emileland/CommandErgo/README.md

# CommandErgo
 Interface manette/clavier pour personne en situation de handicap
