emileland/CommandErgo/teensy/schema png.png

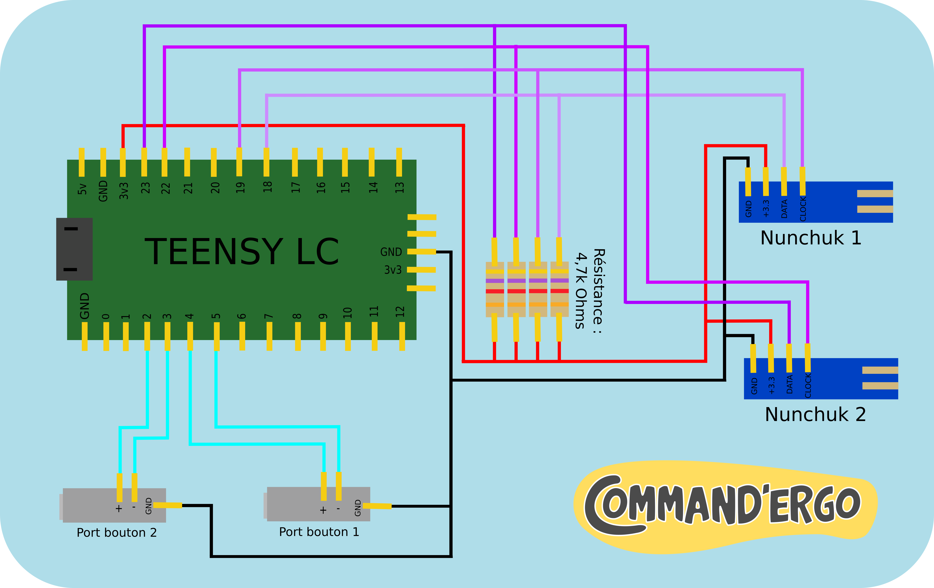
teensy/schema png.png
