emileland/CommandErgo/3D/FreeCAD/Bouton secondaire gauche droite.FCStd

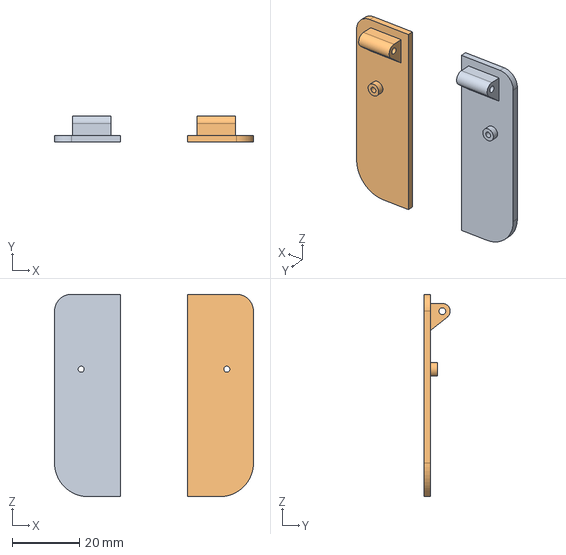
[picture p12: CAD file, 2022-06-10]
3D/FreeCAD/Bouton secondaire gauche droite.FCStd
59.0 x 7.80 x 60.0 mm
Pocket (Mirror #1)
