emileland/CommandErgo/3D/STL/boitier secondaire gauche.stl

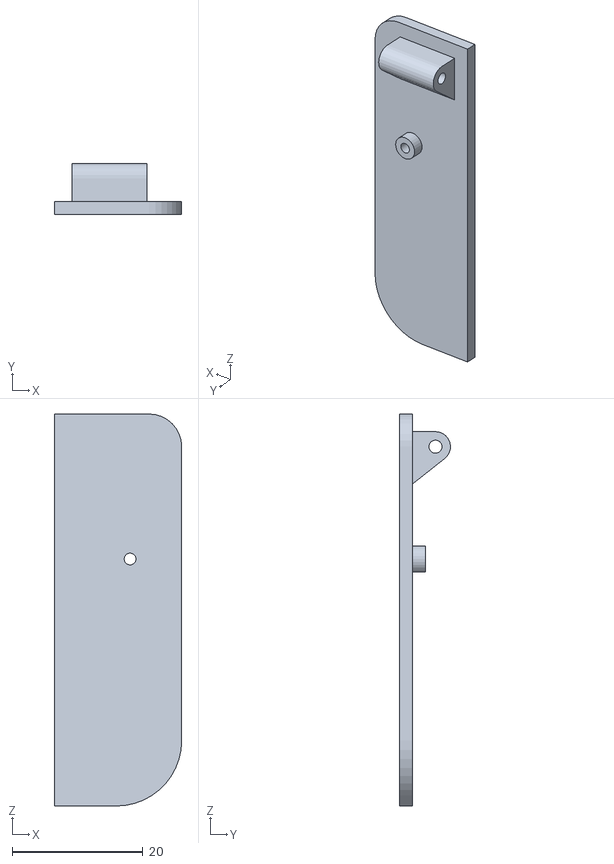
[picture p13: CAD file, 2022-06-10]
3D/STL/boitier secondaire gauche.stl
19.5 x 7.79 x 60.0
