emileland/CommandErgo/3D/FreeCAD/BLOCAGE FIL boutons secondaire .FCStd

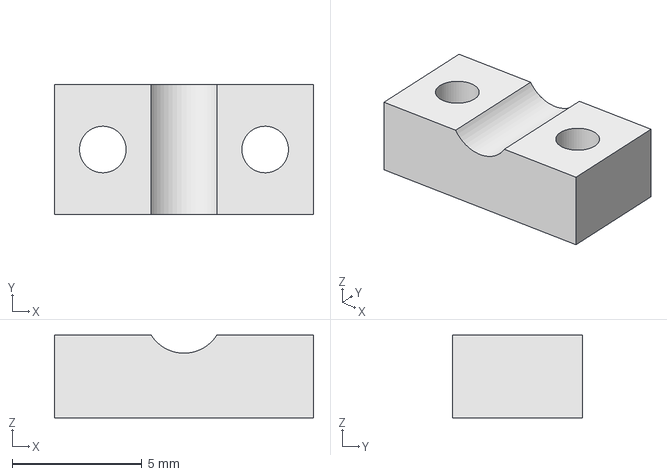
[picture p14: CAD file, 2022-06-10]
3D/FreeCAD/BLOCAGE FIL boutons secondaire .FCStd
10.0 x 5.00 x 3.20 mm
