emileland/CommandErgo/3D/FreeCAD/Couvercle.FCStd

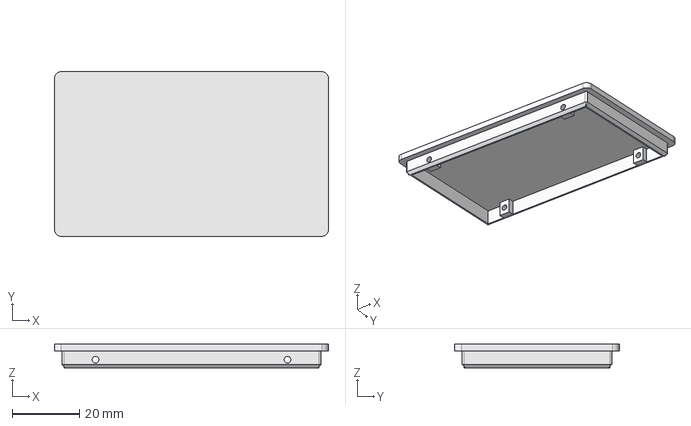
[picture p15: CAD file, 2022-06-10]
3D/FreeCAD/Couvercle.FCStd
81.5 x 49.0 x 7.00 mm
