emileland/CommandErgo/3D/FreeCAD/Boitier.FCStd

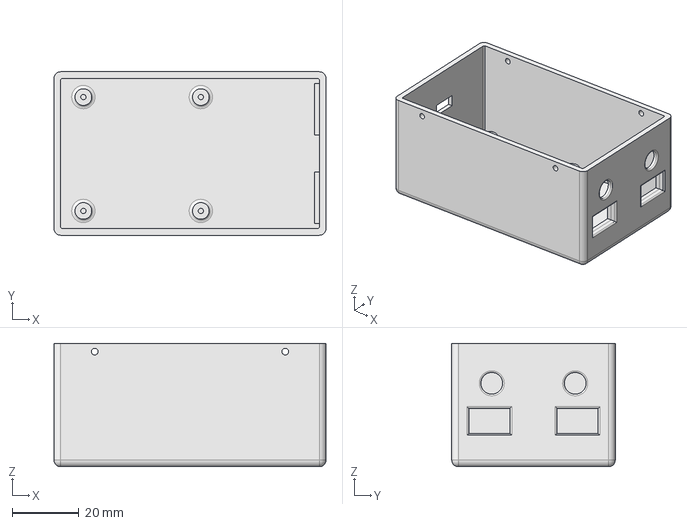
[picture p16: CAD file, 2022-06-10]
3D/FreeCAD/Boitier.FCStd
81.5 x 49.0 x 37.0 mm
