emileland/CommandErgo/3D/STL/boitier secondaire BASE.stl

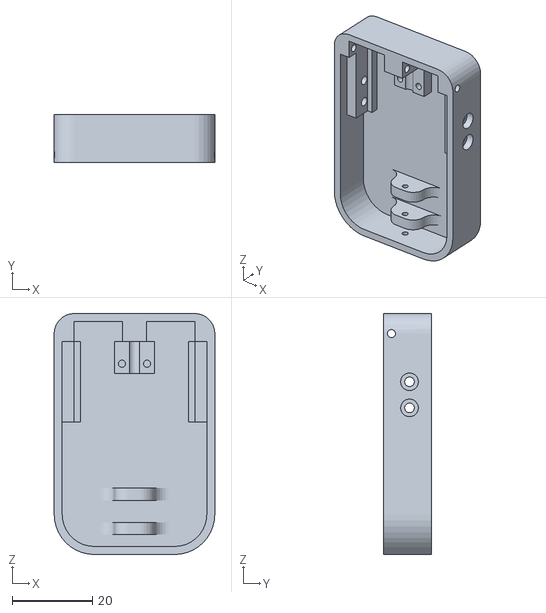
[picture p17: CAD file, 2022-06-10]
3D/STL/boitier secondaire BASE.stl
40.0 x 12.0 x 60.0
