emileland/CommandErgo/(list of files, cad)

Other CAD files:
3D/STL/boitier secondaire droite.stl
3D/STL/boitier secondaire BLOCAGE FIL.stl
3D/FreeCAD/BASE boutons secondaire.FCStd
3D/STL/Boitier.stl
3D/STL/Couvercle.stl
